StevendiwenZhu/EECS452-Final-Report/README.txt

This folder includes reports, posters, demo videos, design files, source code, and documentation.

Team-6-report.pdf: Analysis and summary of this project.
Team-6-poster.pdf: The poster of the project
folder src： Contains all source code files and corresponding documentation.
folder design: All design files and list of our purchase order.

Members of Team Handy Hand:

Name                     U-M email

Shangyan Zhang         shangyan@umich.edu
Shuohui Gao            claregao@umich.edu
Diwen Zhu              diwenzhu@umich.edu
