StevendiwenZhu/EECS452-Final-Report/Team-6-poster.pdf

# Handy Hand

## A mobile robotic arm based on gesture recognition and computer vision

### EECS 452: Digital Signal Processing Design Lab – Fall 2023 Shangyan Zhang, Diwen Zhu, Shuohui Gao

•A mobile robotic arm based on gesture recognition and computer vision
•Pick up and move objects to a given location •A high degree of freedom robotic arm
•A camera module for distance measurement and object recognition
•Control the robot arm in real-time through computer vision

### Overview

### Robotic arm

•A series of interconnected segments with joints that provide degrees of freedom (DOF) for movement
•Flexible, able to reach any positions and orientations
•DC motors controlled by H-bridges
•All H-bridges controlled by the ESP32 (MCU) •Adjustable motor speed

•Using Mediapipe, a framework for building multi-modal (e.g., video, audio, any time series data) application ML pipelines
•Obtain coordinates of the key points of the fingers to identify gestures

### OpenCV

•Open source computer vision library
•Statistical pattern recognition and clustering •Measure distance between object and car

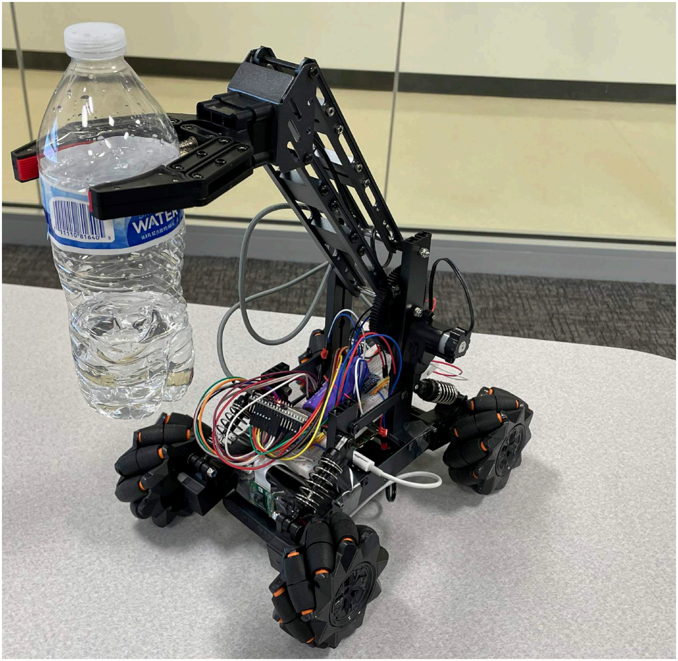
[picture p1: figure]

Figure 2. Product Prototype

### Communication

•Real-time
•Laptop computer sends commands based on gesture recognition
•Raspberry Pi collects command data from PC via WiFi using socket
•Serial communication between Raspberry Pi and ESP32 (MCU)

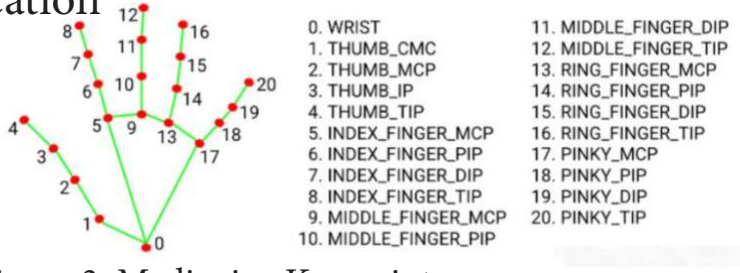
[picture p2: figure]

Figure 3. Mediapipe Key point

### Gesture Recognition

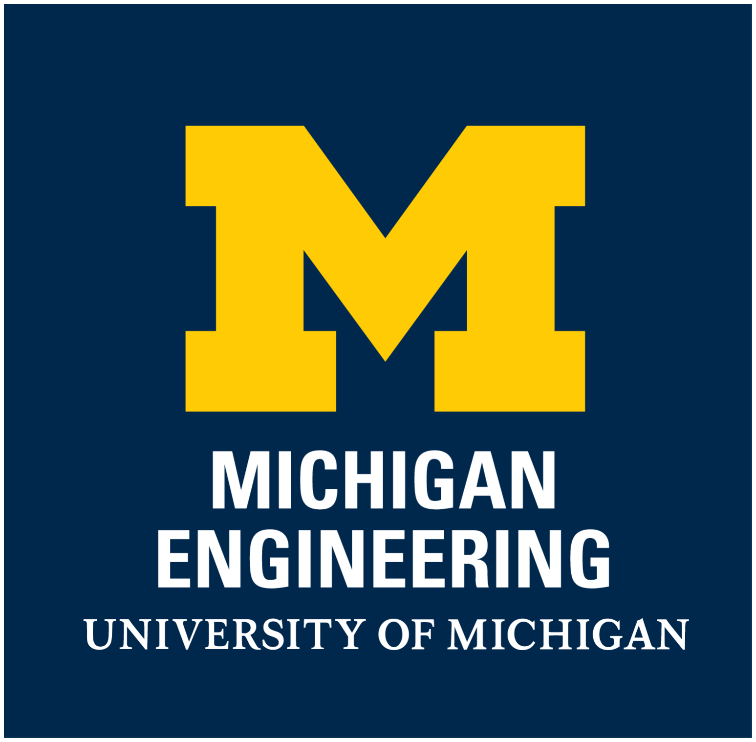
[picture p3: figure]

•PC side: A buffer that identify the most common recognized gesture within 10 frames
•Implement Mediapipe
•Pi side: Adjustable thresholds for on-board camera’s edge detection
•Real-time WiFi communication and Serial communication

### Algorithm

### Result

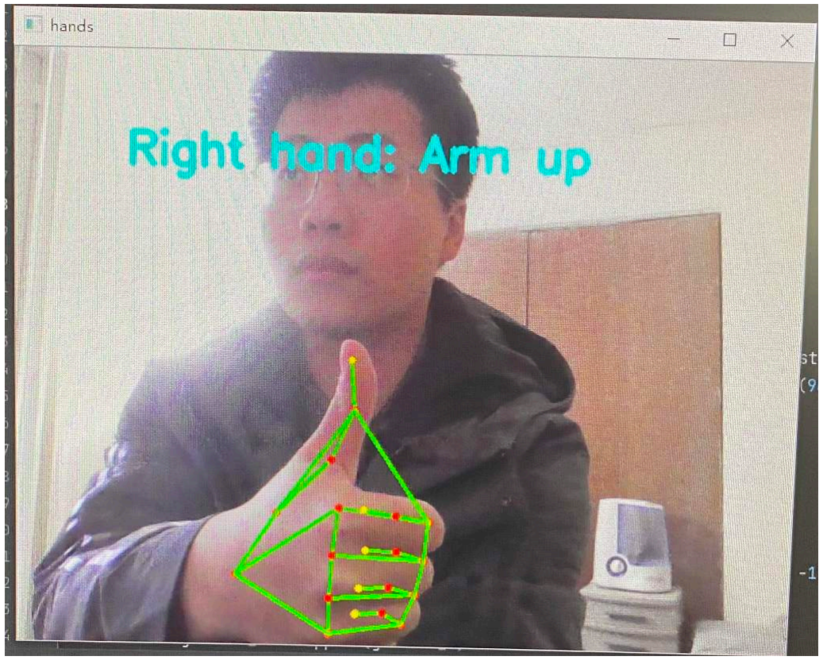
[picture p4: figure]
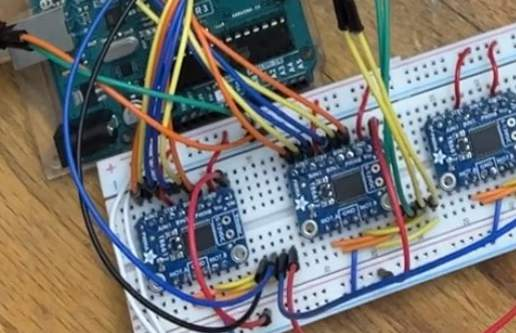
[picture p5: figure]

### System Architecture

### Acknowledgement

Special thanks to Professor Jiasi Chen and GSI Audrey Cooke for all their support, and to the developers of MediaPipe and OpenCV for their contribution.

•0.1s delay communication
•13 types of recognizable hand gesture for both hands •Real-time hand gesture recognition with accuracy higher than 90%
•Reliable distance measurement with error less than 10%
PC Camera | •Real-time driving motors, with fast and slow modes
Gesture
Recognition

Command
via WiFi

Serial
Communication

PWM and
digital input

ESP32 (MCU)

Raspberry Pi

TB6612
H-bridges

DC motors

Figure 4. Mediapipe for hand gesture recognition, circuit layout of H-bridges and MCU

Figure 1. System architecture
