StevendiwenZhu/EECS452-Final-Report/design/Hand_definition.pdf

### Functions of Right hand：

1. Control three forward directions of the car
2. Control the robotic arm
3. Activate the distance calculation module.

Definitions of each gesture of the right hand:

Gesture ‘1’: Forward | Gesture ‘2’: Forward Left | Gesture ‘3’: Forward Right
Gesture ‘open the plam’: Hand open | Gesture ‘close the plam’: Hand close

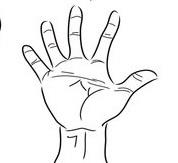
[picture p16: figure]
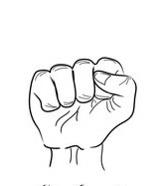
[picture p17: figure]

Gesture ‘Thump up’: Arm up | Gesture ‘Thump down’: Arm down

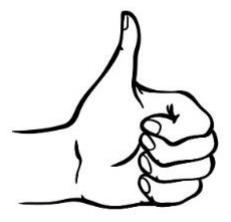
[picture p18: figure]

Gesture ‘√’: Activate the distance calculation module

### Functions of Left hand：

1. Control three backward directions of the car
2. Change the speed mode of the car
3. Activate the distance calculation module.

Definitions of each gesture of the left hand:

Gesture ‘1’: Backward | Gesture ‘2’: Backward Left | Gesture ‘3’: Backward Right

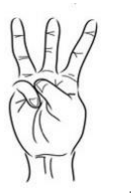
[picture p19: figure]

Gesture ‘Thump only’: Fast mode Gesture ‘Little finger only’:Slow mode

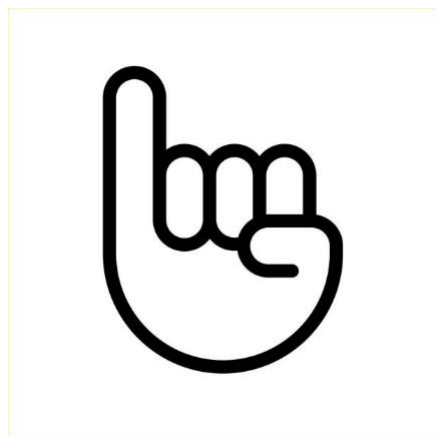
[picture p20: figure]
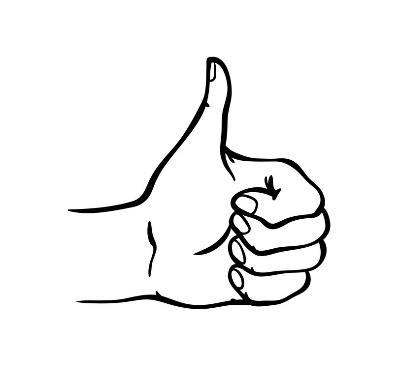
[picture p21: figure]

Gesture ‘√’: Activate the distance calculation module

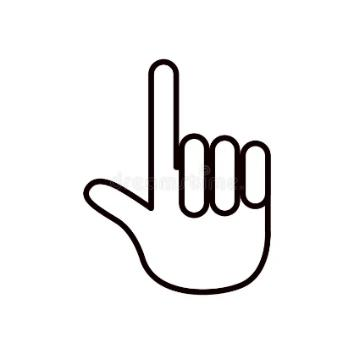
[picture p22: figure]
