StevendiwenZhu/EECS452-Final-Report/design/PCB_design/DXF_HandyHand_PCB.png

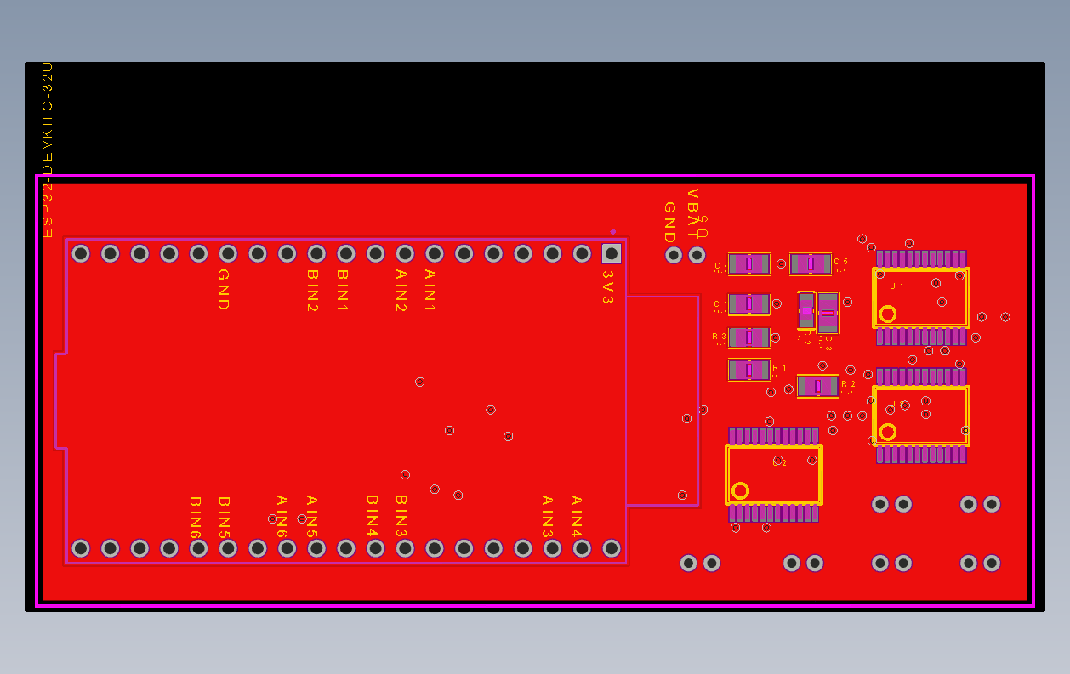
design/PCB_design/DXF_HandyHand_PCB.png
