StevendiwenZhu/EECS452-Final-Report/design/Purchase_List.xlsx

Team Name | Handy Hand
Team Members | Shouhui Gao, Shangyan Zhang, Diwen Zhu
Item | Qty | Price
Robot Arm Kit | 1 | $69.99
Camera module for Raspberry Pi | 1 | $35.00
Battery | 1 | $14.50
Foam blocks | 1 | $15.99
ESP32-DevKitC-32E | 1 | $9.80
JLCPCB | 5 | $20.99
TB6612 | 3 | $20.85
Total |  | $187.12
